SergiiPolokhalo/buryak-pi/docs/buriak_pi_sch_v1.pdf

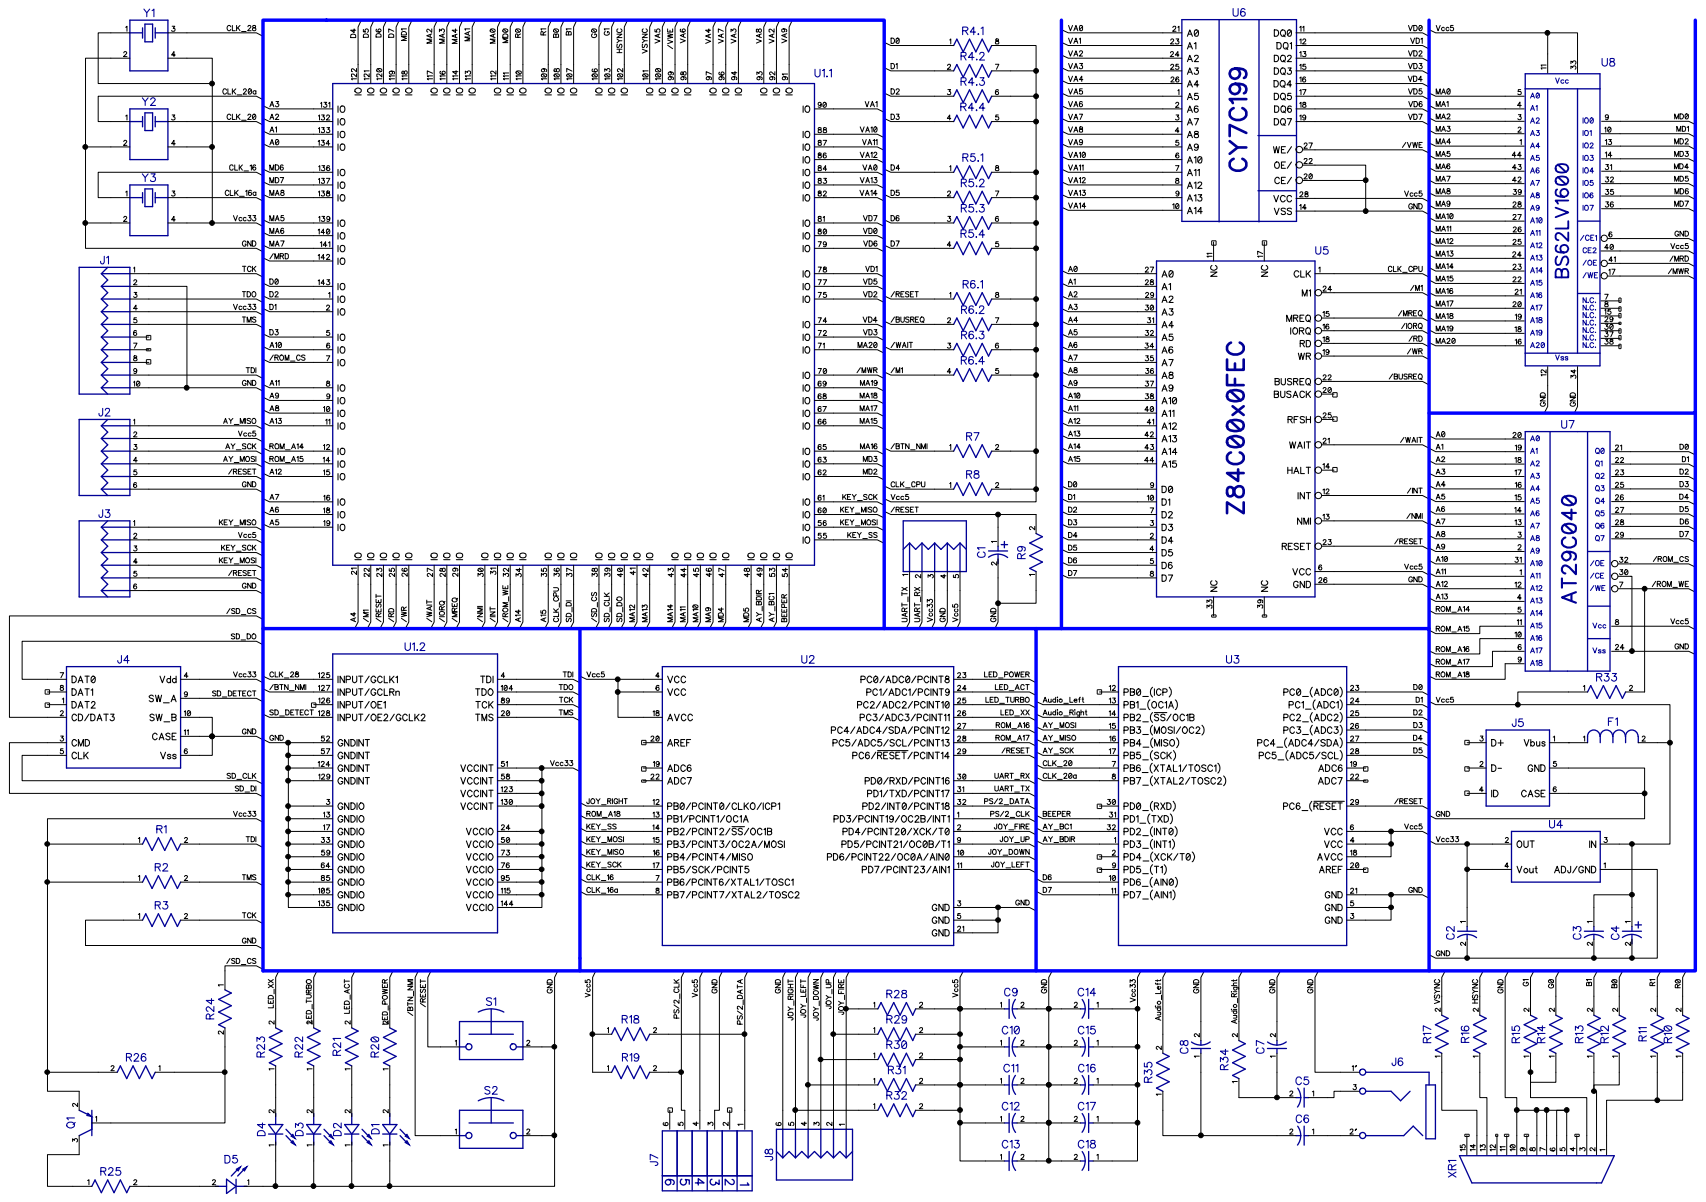
[picture p1: page 1]
