SergiiPolokhalo/buryak-pi/(commit log)

2019-12-11 Fixed Timex HiRes mode
    [firmware_top.vhd, vga_pal.vhd]
2019-12-12 added zxuno UART modules
2019-12-16 fixed joystick bits order
    [cpld_kbd.vhd]
